jh1995/til308-x8-clock/hardware/KiCad/README.md

KiCad 5 files. They use my own library of obsolete parts available in elsewhere in my GitHub area.
