jh1995/til308-x8-clock/software/Arduino/README.md

Arduino firmware of this TIL308/TIL309 display board/clock using 8 digits.
