jh1995/til308-x8-clock/hardware/KiCad/ArduinoNano-TIL308-8x.kicad_pcb

## KiCad design hardware/KiCad/ArduinoNano-TIL308-8x.kicad_pcb (2020-05-09)

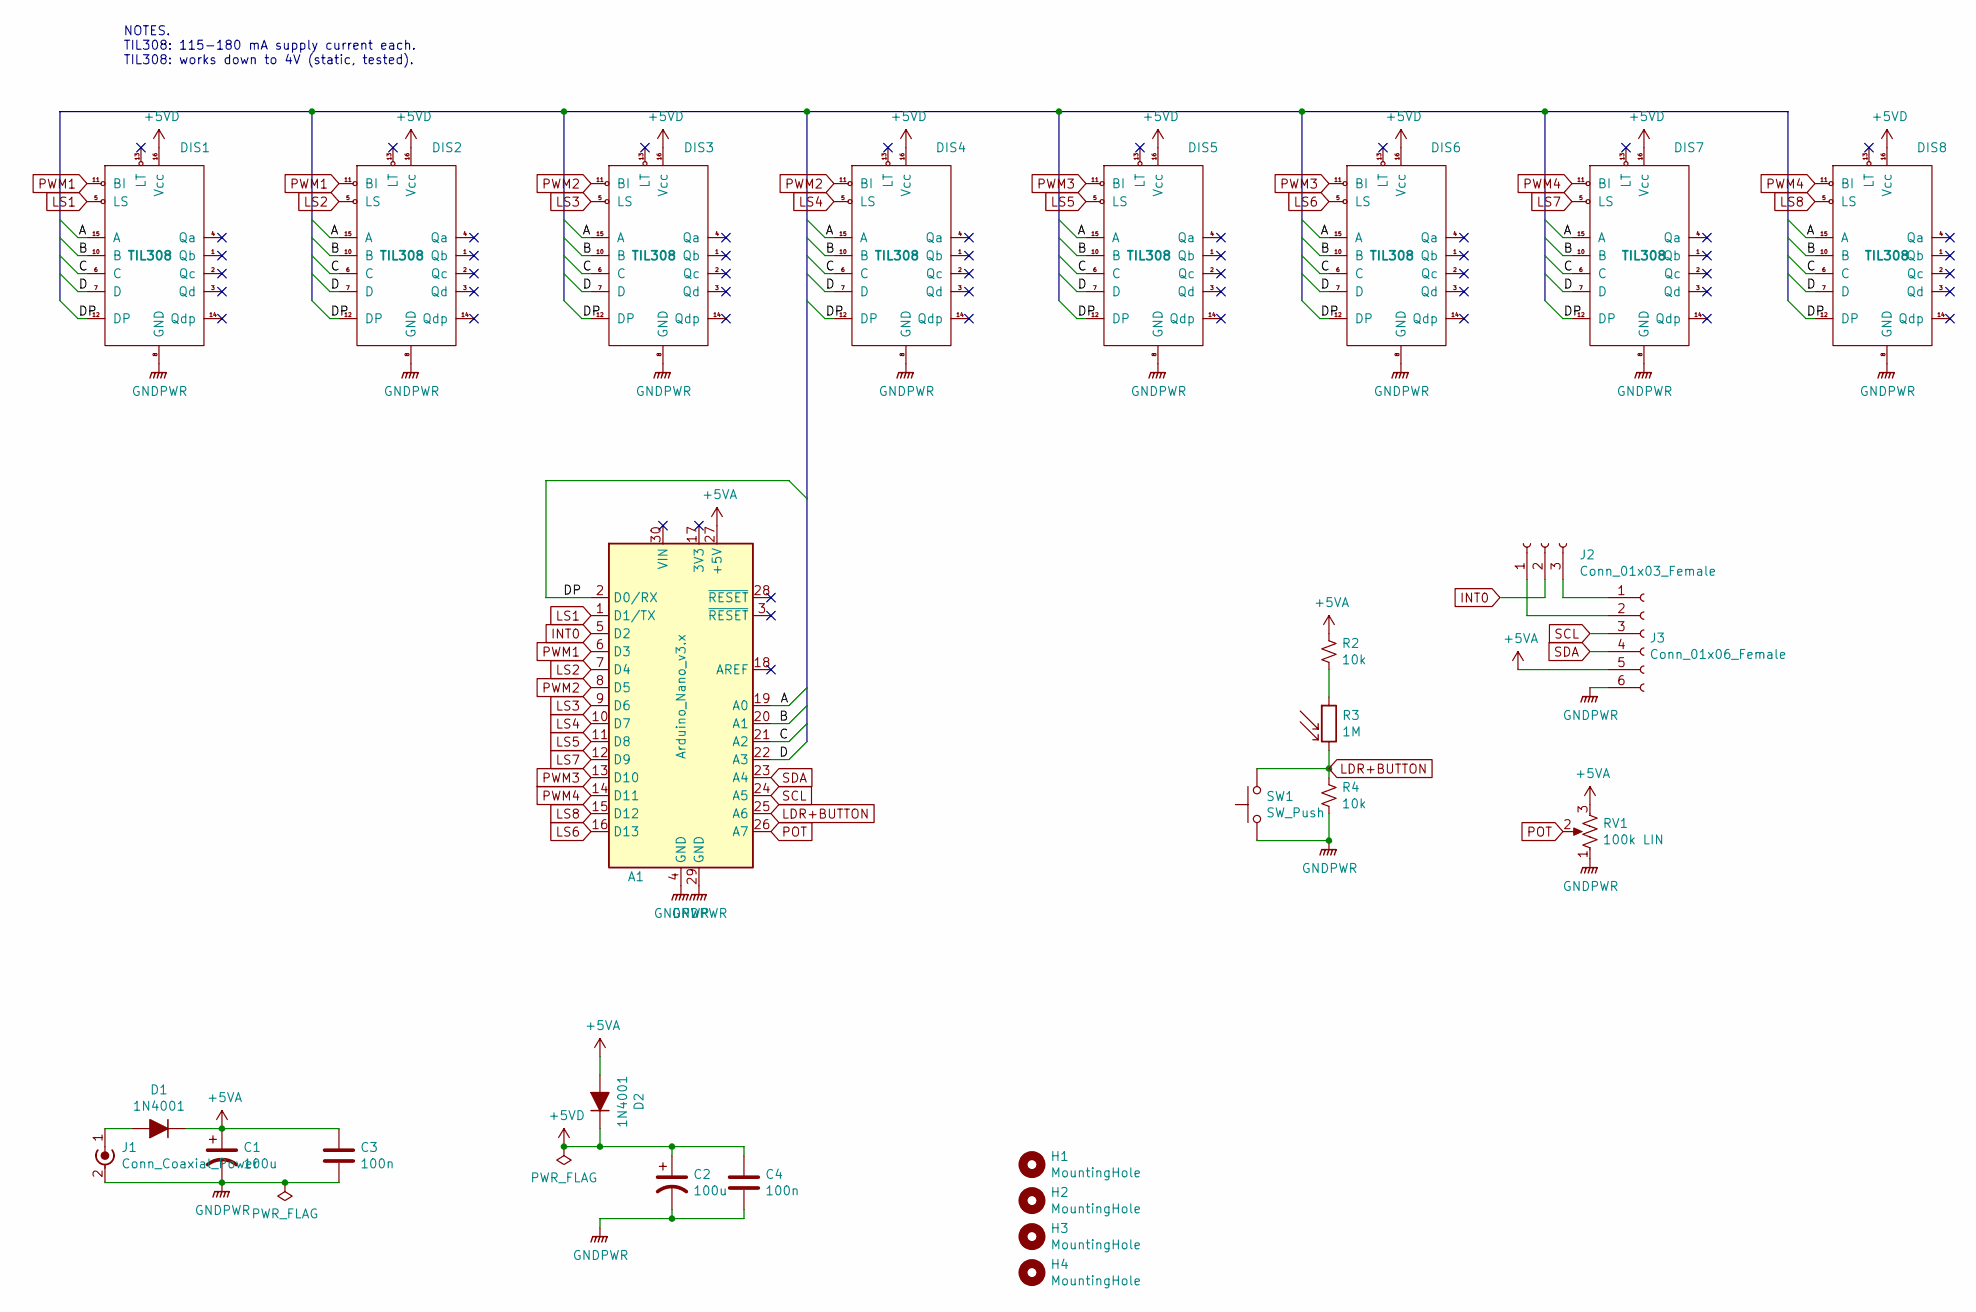
[picture p1: schematic ArduinoNano-TIL308-8x.sch]

Parts:
A1: Arduino_Nano_v3.x; Arduino_Nano
C1, C2: 100u; CP_Radial_D10.0mm_P5.00mm
C3, C4: 100n; C_Rect_L7.0mm_W2.5mm_P5.00mm
D1, D2: 1N4001; D_A-405_P7.62mm_Horizontal
DIS1, DIS2, DIS3, DIS4, DIS5, DIS6, DIS7, DIS8: TIL308
H1, H2, H3, H4: MountingHole; MountingHole_4.3mm_M4
J1: Conn_Coaxial_Power; Molex_KK-254_AE-6410-02A_1x02_P2.54mm_Vertical
J2: Conn_01x03_Female; SolderJumper-3_P1.3mm_Open_Pad1.0x1.5mm_NumberLabels
J3: Conn_01x06_Female; PinSocket_1x06_P2.54mm_Vertical
R2, R4: 10k; R_Axial_DIN0207_L6.3mm_D2.5mm_P2.54mm_Vertical
R3: 1M; PinSocket_1x02_P2.54mm_Vertical
RV1: 100k LIN; Molex_KK-254_AE-6410-03A_1x03_P2.54mm_Vertical
SW1: SW_Push; Molex_KK-254_AE-6410-02A_1x02_P2.54mm_Vertical

Connections:
+5VA: A1.27 (+5V), C1.1, C3.1, D1.1 (K), D2.2 (A), J3.5, R2.1, RV1.3
+5VD: C2.1, C4.1, D2.1 (K), DIS1.16 (Vcc), DIS2.16 (Vcc), DIS3.16 (Vcc), DIS4.16 (Vcc), DIS5.16 (Vcc), DIS6.16 (Vcc), DIS7.16 (Vcc), DIS8.16 (Vcc)
/A: A1.19 (A0), DIS1.15 (A), DIS2.15 (A), DIS3.15 (A), DIS4.15 (A), DIS5.15 (A), DIS6.15 (A), DIS7.15 (A), DIS8.15 (A)
/B: A1.20 (A1), DIS1.10 (B), DIS2.10 (B), DIS3.10 (B), DIS4.10 (B), DIS5.10 (B), DIS6.10 (B), DIS7.10 (B), DIS8.10 (B)
/C: A1.21 (A2), DIS1.6 (C), DIS2.6 (C), DIS3.6 (C), DIS4.6 (C), DIS5.6 (C), DIS6.6 (C), DIS7.6 (C), DIS8.6 (C)
/D: A1.22 (A3), DIS1.7 (D), DIS2.7 (D), DIS3.7 (D), DIS4.7 (D), DIS5.7 (D), DIS6.7 (D), DIS7.7 (D), DIS8.7 (D)
/DP: A1.2 (D0/RX), DIS1.12 (DP), DIS2.12 (DP), DIS3.12 (DP), DIS4.12 (DP), DIS5.12 (DP), DIS6.12 (DP), DIS7.12 (DP), DIS8.12 (DP)
GNDPWR: A1.4 (GND), A1.29 (GND), C1.2, C2.2, C3.2, C4.2, DIS1.8 (GND), DIS2.8 (GND), DIS3.8 (GND), DIS4.8 (GND), DIS5.8 (GND), DIS6.8 (GND), DIS7.8 (GND), DIS8.8 (GND), J1.2 (Ext), J3.6, R4.2, RV1.1, SW1.1
INT0: A1.5 (D2), J2.2
LDR+BUTTON: A1.25 (A6), R3.2, R4.1, SW1.2
LS1: A1.1 (D1/TX), DIS1.5 (LS)
LS2: A1.7 (D4), DIS2.5 (LS)
LS3: A1.9 (D6), DIS3.5 (LS)
LS4: A1.10 (D7), DIS4.5 (LS)
LS5: A1.11 (D8), DIS5.5 (LS)
LS6: A1.16 (D13), DIS6.5 (LS)
LS7: A1.12 (D9), DIS7.5 (LS)
LS8: A1.15 (D12), DIS8.5 (LS)
unnamed: D1.2 (A), J1.1 (In)
unnamed: J2.1, J3.2
unnamed: J2.3, J3.1
unnamed: R2.2, R3.1
POT: A1.26 (A7), RV1.2
PWM1: A1.6 (D3), DIS1.11 (BI), DIS2.11 (BI)
PWM2: A1.8 (D5), DIS3.11 (BI), DIS4.11 (BI)
PWM3: A1.13 (D10), DIS5.11 (BI), DIS6.11 (BI)
PWM4: A1.14 (D11), DIS7.11 (BI), DIS8.11 (BI)
SCL: A1.24 (A5), J3.3
SDA: A1.23 (A4), J3.4

Notes on the sheet:
NOTES. TIL308: 115-180 mA supply current each. TIL308: works down to 4V (static, tested).

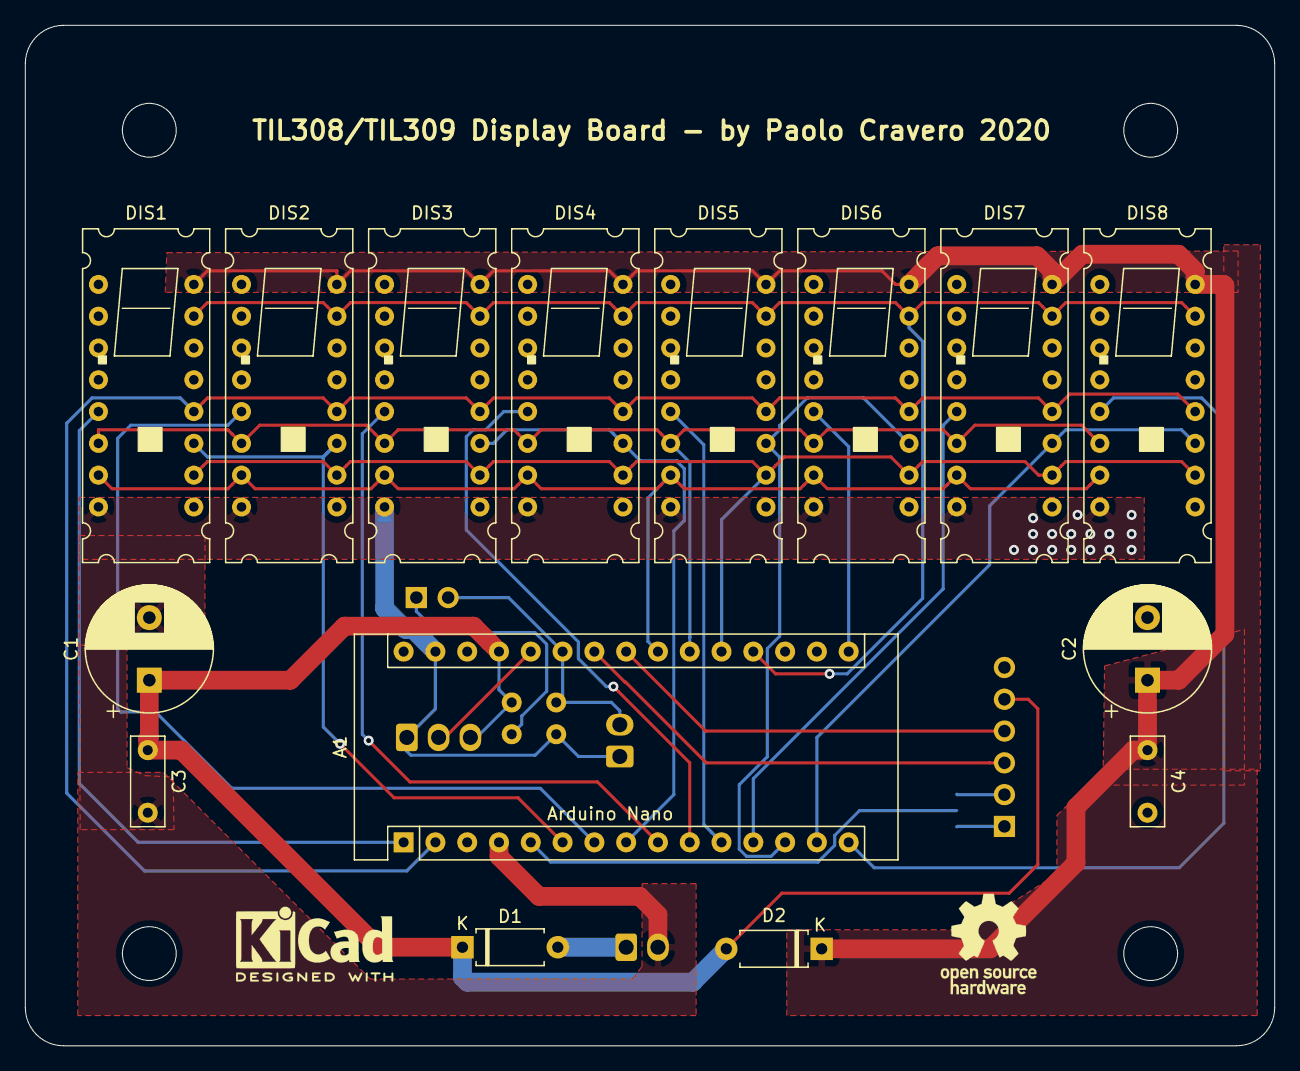
[picture p2: board ArduinoNano-TIL308-8x.kicad_pcb from above]

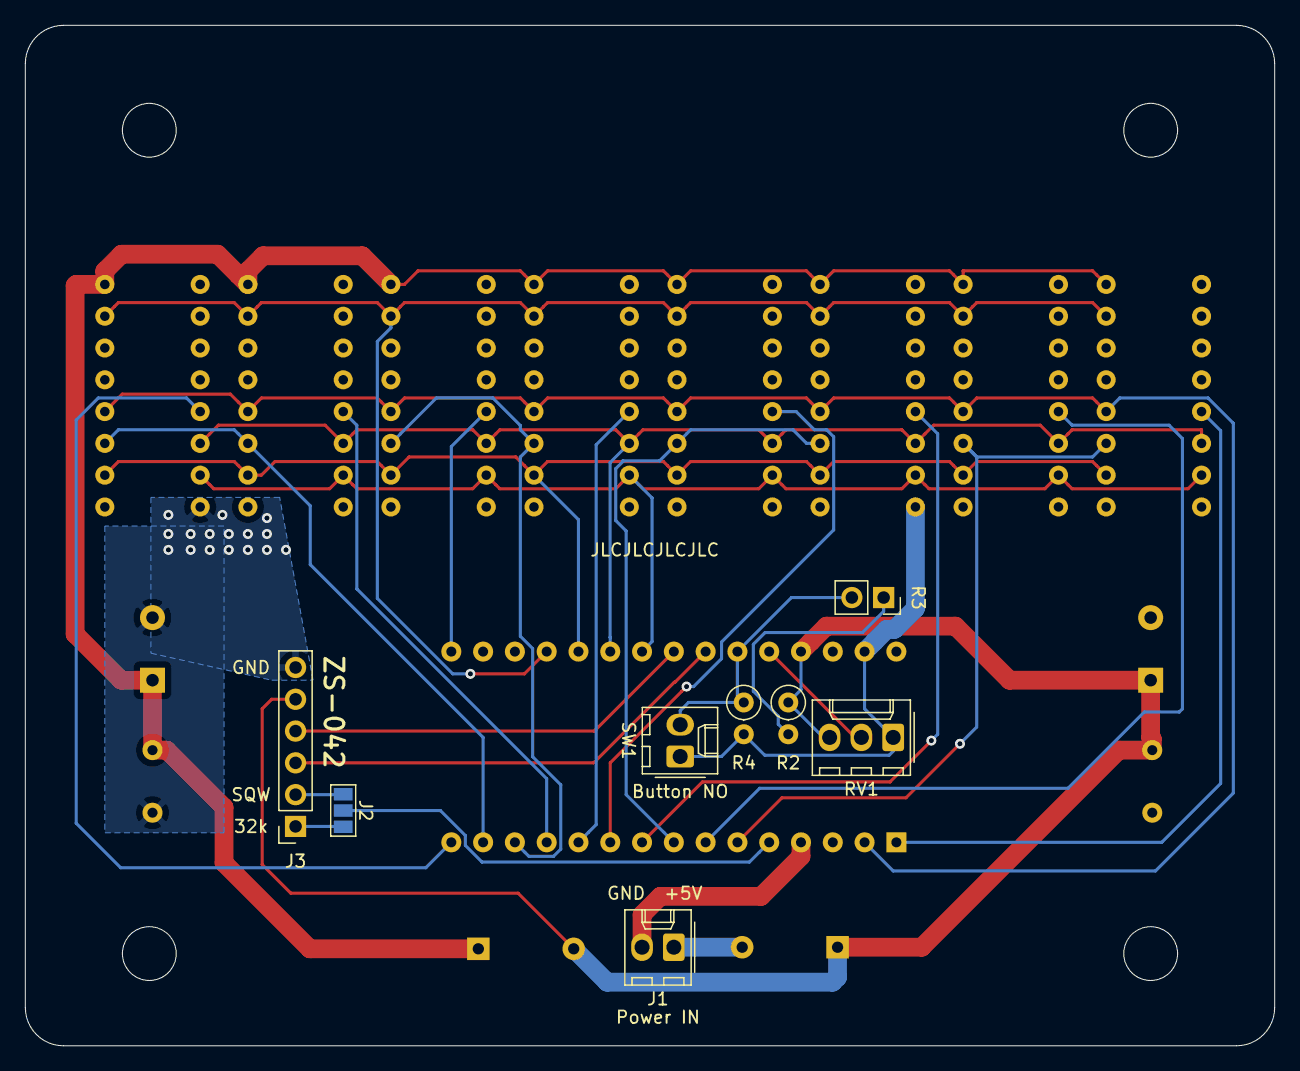
[picture p3: board ArduinoNano-TIL308-8x.kicad_pcb from below]

Board: 2 copper layers, 99.8 x 81.5 mm, 27 parts (8 on the bottom side), 29 nets.
