jh1995/til308-x8-clock/(threads)

Thread 1 (2020-12-22):

Button press in complete darkness

jh1995, 2020-12-22:
100% darkness triggers the "button pressed" action. Probably the LDR value range needs to be tamed with a resistor in parallel.

jh1995, 2020-12-26:
wire a 80-100 kohm resistor in parallel between +5V and ADC pin reading the pot; adjust decision levels in firmware accordingly.

Closed 2020-12-26.
