jh1995/til308-x8-clock/(commit log)

2020-05-09 Files used to fab first PCB run
    [ArduinoNano-TIL308-8x.kicad_pcb, ArduinoNano-TIL308-8x.sch]
2021-01-06 +dayOfWeek, fixes
    Added experimental display of day of the week. Bug fixes.
    [TIL308-x8-clock.ino]
